ManiacalLabs/Bixel/PCB/SingleTest/SingleTest.kicad_pcb

## KiCad design PCB/SingleTest/SingleTest.kicad_pcb (2018-06-30)

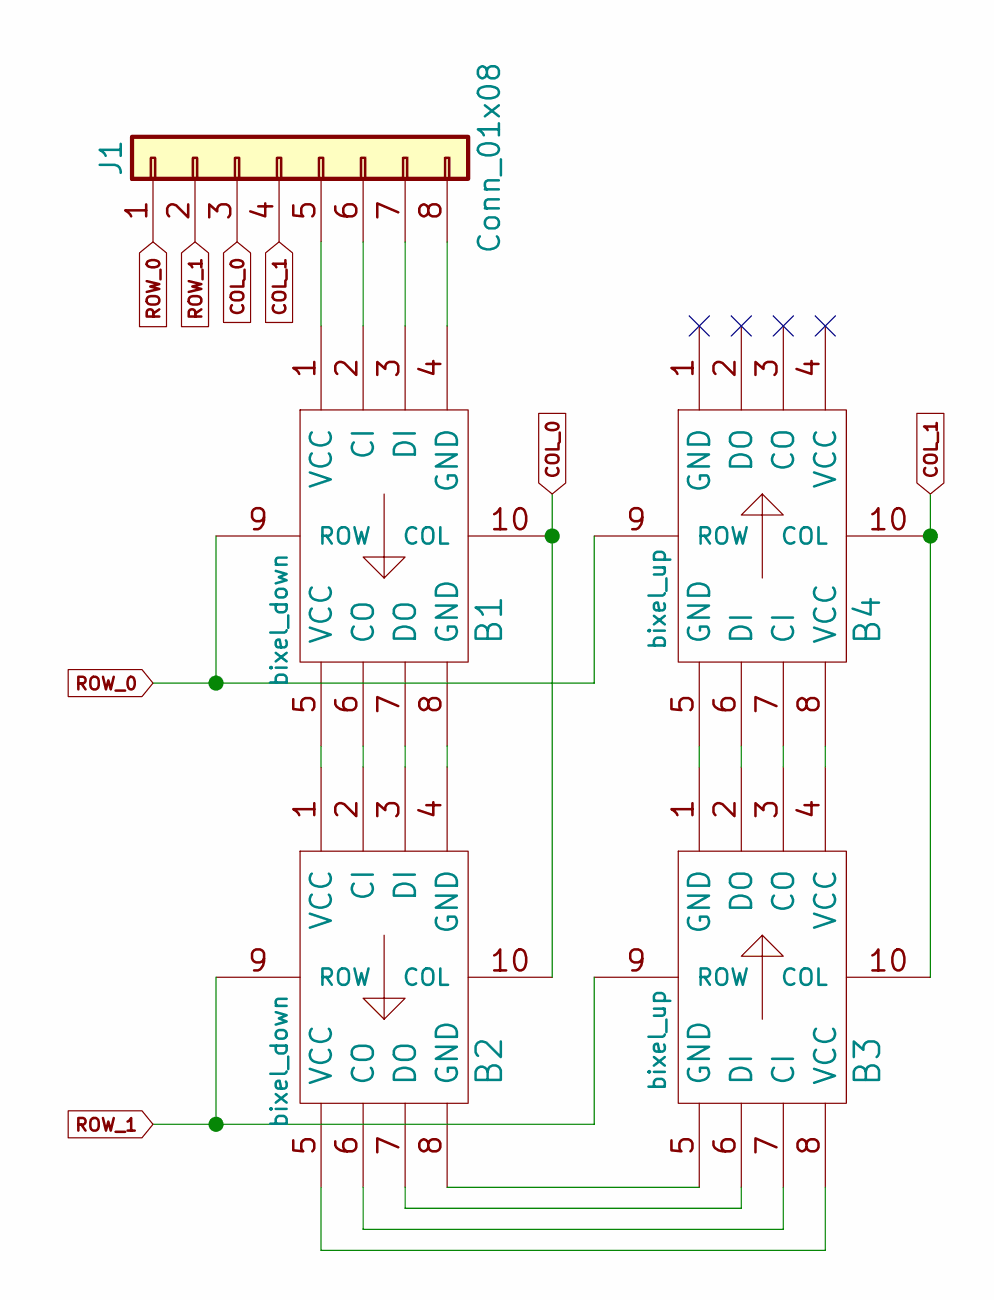
[picture p8: schematic SingleTest.sch]

Parts:
B1, B2: bixel_down
B3, B4: bixel_up
J1: Conn_01x08

Connections:
COL_0: B1.10 (COL), B2.10 (COL), J1.3
COL_1: B3.10 (COL), B4.10 (COL), J1.4
unnamed: B1.1 (VCC), J1.5
unnamed: B1.2 (CI), J1.6
unnamed: B1.3 (DI), J1.7
unnamed: B1.4 (GND), J1.8
unnamed: B1.5 (VCC), B2.1 (VCC)
unnamed: B1.6 (CO), B2.2 (CI)
unnamed: B1.7 (DO), B2.3 (DI)
unnamed: B1.8 (GND), B2.4 (GND)
unnamed: B2.5 (VCC), B3.8 (VCC)
unnamed: B2.6 (CO), B3.7 (CI)
unnamed: B2.7 (DO), B3.6 (DI)
unnamed: B2.8 (GND), B3.5 (GND)
unnamed: B3.1 (GND), B4.5 (GND)
unnamed: B3.2 (DO), B4.6 (DI)
unnamed: B3.3 (CO), B4.7 (CI)
unnamed: B3.4 (VCC), B4.8 (VCC)
ROW_0: B1.9 (ROW), B4.9 (ROW), J1.1
ROW_1: B2.9 (ROW), B3.9 (ROW), J1.2

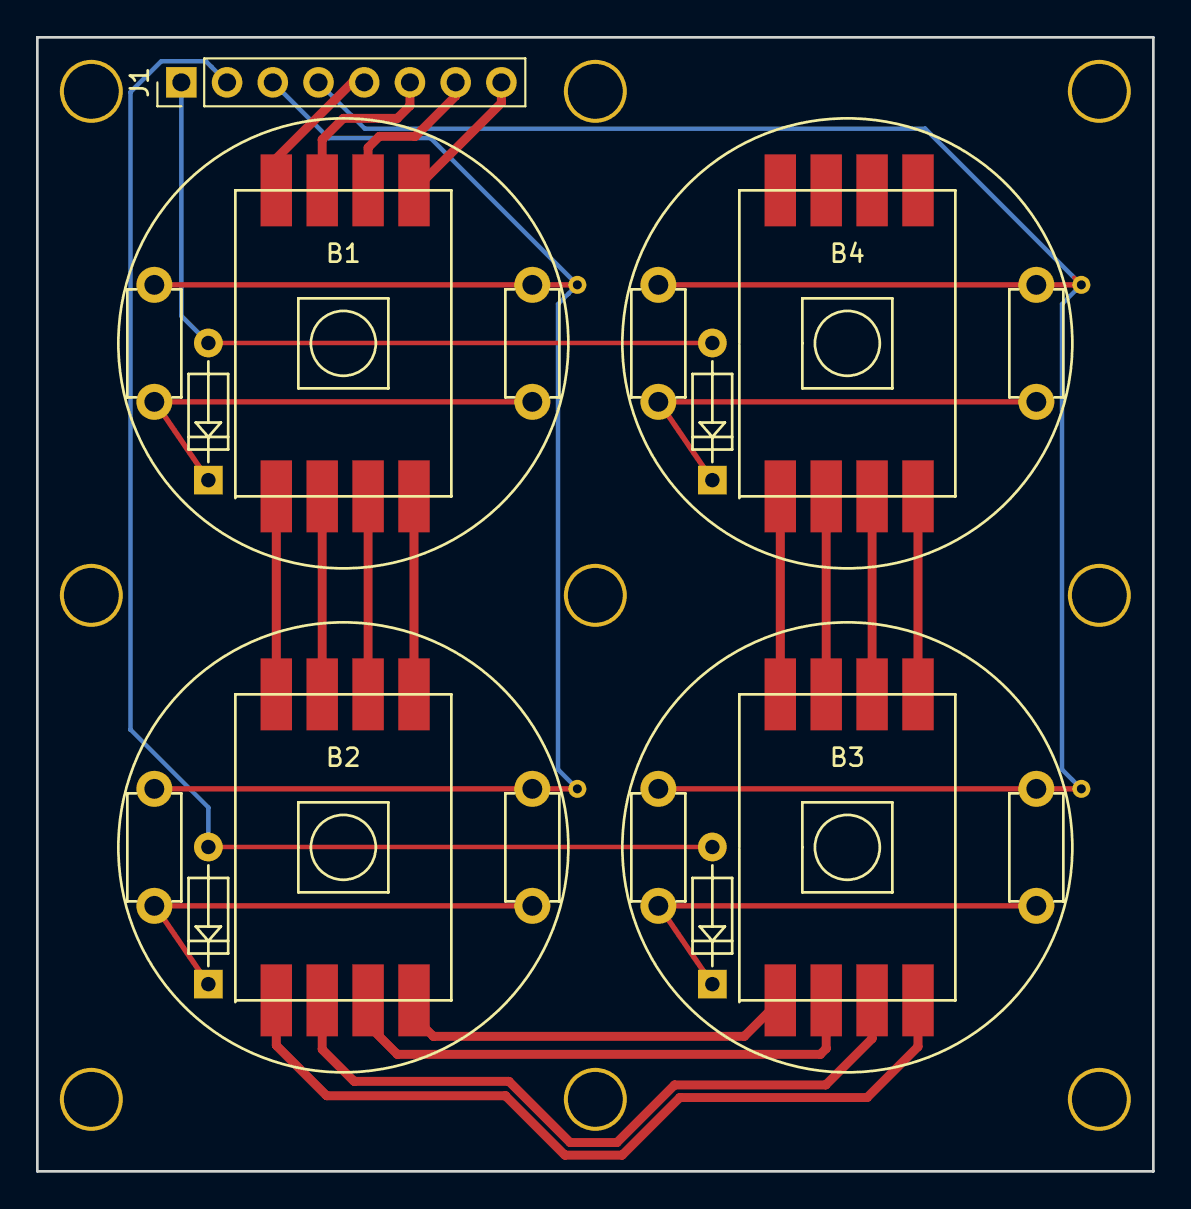
[picture p9: board SingleTest.kicad_pcb from above]

Board: 2 copper layers, 62.0 x 63.0 mm, 5 parts (0 on the bottom side), 20 nets.
