ManiacalLabs/Bixel/MainApp/bixel/driver_base.py

import time


class ChannelOrder:
    RGB = [0, 1, 2]
    RBG = [0, 2, 1]
    GRB = [1, 0, 2]
    GBR = [1, 2, 0]
    BRG = [2, 0, 1]
    BGR = [2, 1, 0]


class DriverBase(object):
    """Base driver class to build other drivers from"""

    def __init__(self, pixels, c_order=ChannelOrder.RGB, gamma=None):
        self.pixels = pixels
        self.numLEDs = self.pixels.numLEDs
        self.gamma = gamma or range(256)

        self.c_order = c_order

        self.bufByteCount = int(3 * self.numLEDs)
        self._buf = [0] * self.bufByteCount

        self._thread = None
        self.lastUpdate = 0

    def __enter__(self):
        return self

    def __exit__(self, type, value, traceback):
        pass

    def cleanup(self):
        return self.__exit__(None, None, None)

    # Push new data to strand
    def update(self):
        self._update(self.pixels.buffer)

    def sync(self):
        pass

    def setMasterBrightness(self, brightness):
        return False

    def _fixData(self, data):
        gamma = self.gamma
        for a, b in enumerate(self.c_order):
            self._buf[a:self.numLEDs * 3:3] = [gamma[v] for v in data[b::3]]
