ManiacalLabs/Bixel/MainApp/bixel/font.py

GLCDFONT = [
    [0x00, 0x00, 0x00, 0x00, 0x00],
    [0x3E, 0x5B, 0x4F, 0x5B, 0x3E],
    [0x3E, 0x6B, 0x4F, 0x6B, 0x3E],
    [0x1C, 0x3E, 0x7C, 0x3E, 0x1C],
    [0x18, 0x3C, 0x7E, 0x3C, 0x18],
    [0x1C, 0x57, 0x7D, 0x57, 0x1C],
    [0x1C, 0x5E, 0x7F, 0x5E, 0x1C],
    [0x00, 0x18, 0x3C, 0x18, 0x00],
    [0xFF, 0xE7, 0xC3, 0xE7, 0xFF],
    [0x00, 0x18, 0x24, 0x18, 0x00],
    [0xFF, 0xE7, 0xDB, 0xE7, 0xFF],
    [0x30, 0x48, 0x3A, 0x06, 0x0E],
    [0x26, 0x29, 0x79, 0x29, 0x26],
    [0x40, 0x7F, 0x05, 0x05, 0x07],
    [0x40, 0x7F, 0x05, 0x25, 0x3F],
    [0x5A, 0x3C, 0xE7, 0x3C, 0x5A],
    [0x7F, 0x3E, 0x1C, 0x1C, 0x08],
    [0x08, 0x1C, 0x1C, 0x3E, 0x7F],
    [0x14, 0x22, 0x7F, 0x22, 0x14],
    [0x5F, 0x5F, 0x00, 0x5F, 0x5F],
    [0x06, 0x09, 0x7F, 0x01, 0x7F],
    [0x00, 0x66, 0x89, 0x95, 0x6A],
    [0x60, 0x60, 0x60, 0x60, 0x60],
    [0x94, 0xA2, 0xFF, 0xA2, 0x94],
    [0x08, 0x04, 0x7E, 0x04, 0x08],
    [0x10, 0x20, 0x7E, 0x20, 0x10],
    [0x08, 0x08, 0x2A, 0x1C, 0x08],
    [0x08, 0x1C, 0x2A, 0x08, 0x08],
    [0x1E, 0x10, 0x10, 0x10, 0x10],
    [0x0C, 0x1E, 0x0C, 0x1E, 0x0C],
    [0x30, 0x38, 0x3E, 0x38, 0x30],
    [0x06, 0x0E, 0x3E, 0x0E, 0x06],
    [0x00, 0x00, 0x00, 0x00, 0x00],
    [0x00, 0x00, 0x5F, 0x00, 0x00],
    [0x00, 0x07, 0x00, 0x07, 0x00],
    [0x14, 0x7F, 0x14, 0x7F, 0x14],
    [0x24, 0x2A, 0x7F, 0x2A, 0x12],
    [0x23, 0x13, 0x08, 0x64, 0x62],
    [0x36, 0x49, 0x56, 0x20, 0x50],
    [0x00, 0x08, 0x07, 0x03, 0x00],
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
]

TINYFONT = [
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
    [0x0000, 0x0638, 0x0c7c, 0x0844, 0x3847, 0x3847, 0x0fcc, 0x0798],
    [0x0000, 0x0c30, 0x0630, 0x0300, 0x0180, 0x00c0, 0x0c60, 0x0c30],
    [0x0000, 0x0780, 0x0fd8, 0x087c, 0x08e4, 0x07bc, 0x0fd8, 0x0840],
    [0x0000, 0x0000, 0x0000, 0x001e, 0x000e, 0x0000, 0x0000, 0x0000],
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
]

fw, fh = 6, 8
fonts = {
    '8x6': {
        'data': GLCDFONT,
        'height': 8,
        'bounds': (0, 255),
        'undef': [0x00, 0x00, 0x00, 0x00, 0x00],
        'sep': 1
    },
    '6x4': {
        'data': TINYFONT,
        'height': 6,
        'bounds': (0, 255),
        'undef': [0x1f, 0x1f, 0x1f],
        'sep': 1
    },
    '16x8': {
        'data': LARGEFONT,
        'height': 16,
        'bounds': (0, 127),
        'undef': [0x0000, 0x0000, 0x0000, 0x0000, 0x0000, 0x0000, 0x0000, 0x0000],
        'sep': 2
    }
}

default_font = '6x4'


def str_dim(text, font=default_font, font_scale=1, final_sep=True):
    f = fonts[font]
    fh = f['height']
    FONT = f['data']
    y = font_scale * fh
    x_list = []
    x = 0
    for c in text:
        if c == '\n':
            y += font_scale * fh
            x = 0
        elif c == '\r':
            pass  # skip it
        else:
            c = ord(c)  # make it the int value
            if c < f['bounds'][0] or c > f['bounds'][1]:
                c_data = f['undef']
            else:
                c_data = FONT[c - f['bounds'][0]]

            fw = len(c_data)
            fw += f['sep']
            x += font_scale * fw
        x_list.append(x)

        if not final_sep:
            x_list = [xi - font_scale * f['sep'] for xi in x_list]

    return (max(x_list), y)


def get_font_menu_options():
    options = {}
    options_map = []
    count = 0
    for k in fonts.keys():
        options[count] = k
        options_map.append(k)
        count += 1
    return (options, options_map)
