ManiacalLabs/Bixel/(commit log)

2018-06-02 starting PCB test
    [BixelSmallProto.kicad_pcb, BixelSmallProto.sch]
2018-06-17 Updating with button read loop time test code
2018-06-20 buttons and leds at same time!
2018-06-29 Starting aggregate footprints
    [SingleTest.kicad_pcb, SingleTest.sch]
2018-06-29 Adding single test
    [SingleTest.sch, _saved_SingleTest.sch]
2018-06-30 Adding labels
    [SingleTest.kicad_pcb]
2018-06-30 fix row0
    [SingleTest.kicad_pcb]
2018-07-11 Starting 16x16 Bixel
    [Bixel.kicad_pcb, Bixel.sch]
2018-07-11 More 16x16 work
    [Bixel.kicad_pcb]
2018-07-12 Starting the wiring in the schematic
    [Bixel.sch]
2018-07-12 Shift Register schematic layout
    [Bixel.sch]
2018-07-13 adding chained 595 example
    [BixelSmallProto.sch]
2018-07-13 More work on schematic. Unable to auto-place footprints on PCB.
    [Bixel.kicad_pcb, Bixel.sch]
2018-07-14 Button interrupts
2018-07-14 starting bixel layout, fixed schematic symbol
    [Bixel.kicad_pcb, Bixel.sch]
2018-07-15 Working on bixel layout
    [Bixel.kicad_pcb]
2018-07-15 Finished Bixel layout
    [Bixel.kicad_pcb]
2018-07-15 More work on PCB layout
    [Bixel.kicad_pcb, Bixel.sch]
2018-07-15 Added moutning holes
    [Bixel.kicad_pcb]
2018-07-15 Yet more work on Bixel layout. Added 2x12 header, 3V3 for shifters
    [Bixel.kicad_pcb, Bixel.sch]
2018-07-15 More Layout Work
    [Bixel.kicad_pcb, Bixel.sch]
2018-07-15 Re-working schematic and layout for easier routing of LED power
    [Bixel.kicad_pcb, Bixel.sch]
2018-07-15 More work on PCB Layout.
    [Bixel.kicad_pcb, Bixel.sch]
2018-07-15 Wired up shifters, 5V, GND pours
    [Bixel.kicad_pcb]
2018-07-15 Fixed shifter trace width and LED header-to-B1 signal routing
    [Bixel.kicad_pcb]
2018-07-16 Added mounting holes
    [Bixel.kicad_pcb]
2018-07-16 Initial draft of layout complete.
    [Bixel.sch]
2018-07-16 Initial generation of gerber files per Seeed Specs
    [Bixel-B.Cu.gbl, Bixel-B.Mask.gbs, Bixel-B.SilkS.gbo, Bixel-Edge.Cuts.gm1, Bixel-F.Cu.gtl, Bixel-F.Mask.gts, Bixel-F.SilkS.gto, Bixel.drl]
2018-07-16 Few minor tweaks, re-gen of gerber files for review.
    [Bixel-B.Cu.gbl, Bixel-B.Mask.gbs, Bixel-B.SilkS.gbo, Bixel-Edge.Cuts.gm1, Bixel-F.Cu.gtl, Bixel-F.Mask.gts, Bixel-F.SilkS.gto, Bixel.drl]
2018-07-18 Changed screw terminal footprint to 3.5mm pitch
    [Bixel.sch]
2018-07-19 Added trace to top GND terminal, replotted gerbers
    [Bixel-B.Cu.gbl, Bixel-B.Mask.gbs, Bixel-B.SilkS.gbo, Bixel-Edge.Cuts.gm1, Bixel-F.Cu.gtl, Bixel-F.Mask.gts, Bixel-F.SilkS.gto, Bixel.drl]
2018-07-20 Final pre-submit commit.
    [Bixel-B.Cu.gbl, Bixel-B.Mask.gbs, Bixel-B.SilkS.gbo, Bixel-Edge.Cuts.gm1, Bixel-F.Cu.gtl, Bixel-F.Mask.gts, Bixel-F.SilkS.gto, Bixel.drl]
2018-07-20 Breaking up buttons and leds
2018-07-20 Working on APA102 driver
2018-07-20 tweaking apa driver
2018-07-20 Cleanup and rework for pi
    [colors.py, coords.py, driver_base.py, interval.py, matrix.py]
2018-07-20 Adding control carrier PCB
    [ControlCarrier.kicad_pcb, ControlCarrier.sch]
2018-07-21 Adding controller carrier
    [ControlCarrier.sch]
2018-07-21 enlarged carrier board
    [ControlCarrier.kicad_pcb]
2018-08-13 fix select new game
    [runner.py]
2018-09-03 gravity works on all buttons now
